JJ1SLR/MorseListening/README.md

# MorseListening
This is a project running on Arduino UNO/Nano.<br>
The first version (V0.1.0) of this project was released on Oct. 24, 2020<br>
It's a Morse code listening practice device to play Morse code by a passive buzzer and controlled by a infrared remote controller.<br>
[Detailed introduction (PDF, in Japanese) (PDF, 日本語)](https://github.com/JJ1SLR/MorseListening/blob/master/Document/MorseListening_JJ1SLR_JP.pdf)<br>

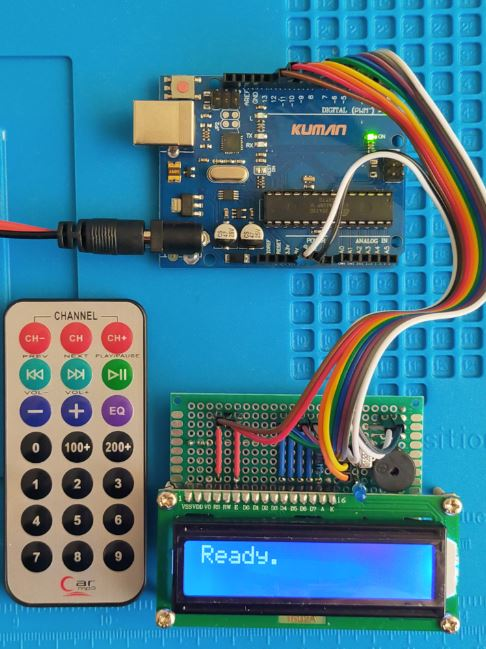
[picture p1: Document/images/overview.jpg]
Overview
<br>

The hardware is mainly constructed with the following parts:<br>
An Arduino UNO<br>
An LCD display 1602A <br>
An IR Receiver 1838<br>
A passive buzzer<br>
An LED<br>
A diode 1N4148<br>
Some resistors, etc.<br>

Circuit diagram<br>
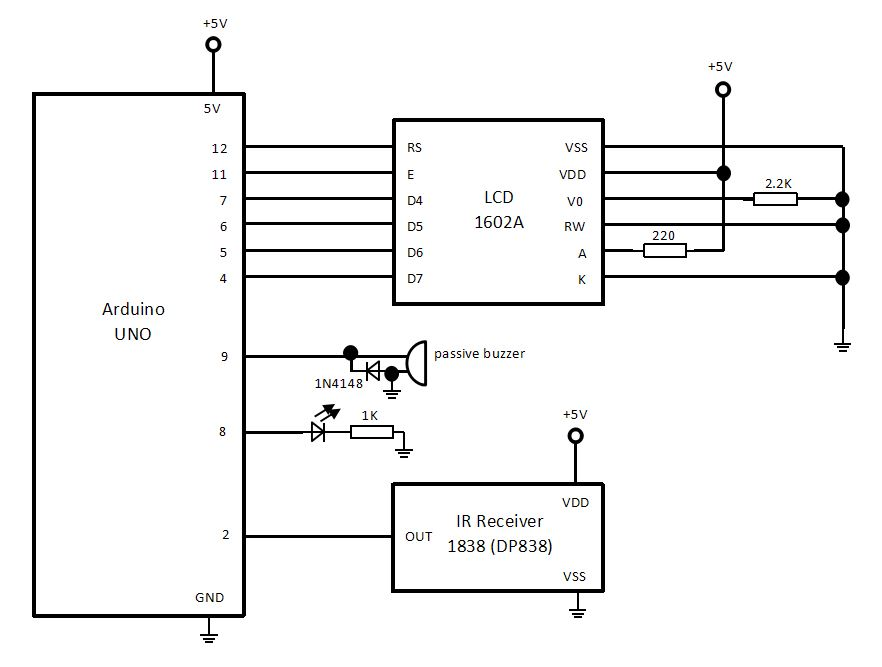
[picture p2: Document/circuit.JPG]
circuit diagram
<br>

The morse code here is stipulated by the Japanese law [無線局運用規則　別表第一号　モールス符号（第十二条関係）]
(https://www.tele.soumu.go.jp/horei/reiki_honbun/72393000001.html)<br>
But the Wabun code is not supported.
