JJ1SLR/MorseListening/Document/images/callsign.jpg

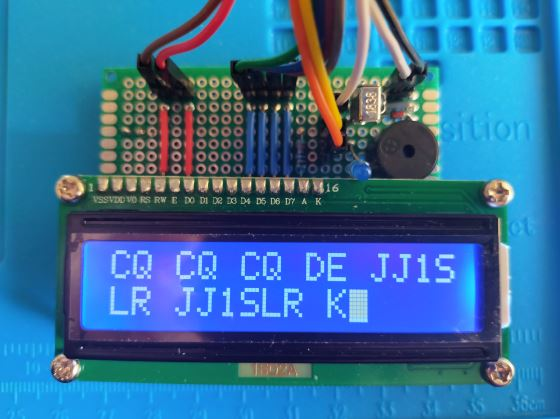
Document/images/callsign.jpg
