JJ1SLR/MorseListening/Document/images/case.jpg

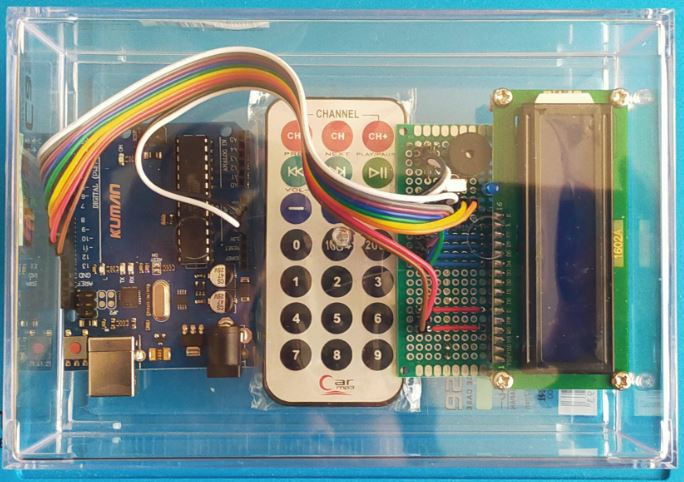
Document/images/case.jpg
