JJ1SLR/MorseListening/Document/images/charactor.jpg

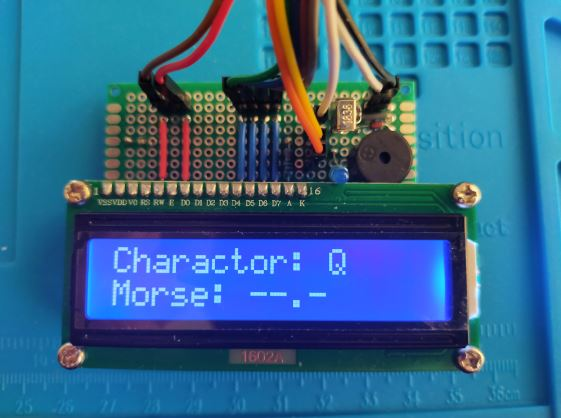
Document/images/charactor.jpg
