JJ1SLR/MorseListening/Document/images/random1.jpg

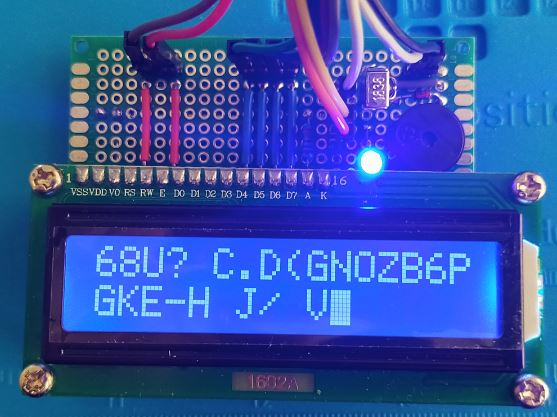
Document/images/random1.jpg
