JJ1SLR/MorseListening/Document/images/random2.jpg

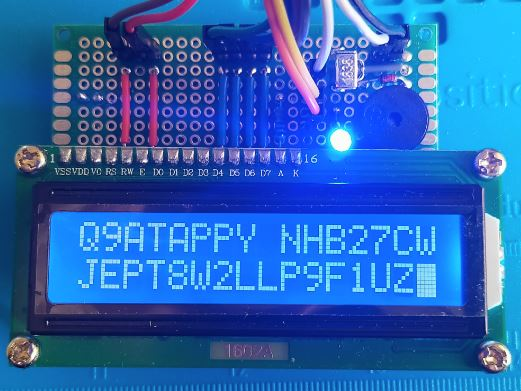
Document/images/random2.jpg
