JJ1SLR/MorseListening/Document/images/random3.jpg

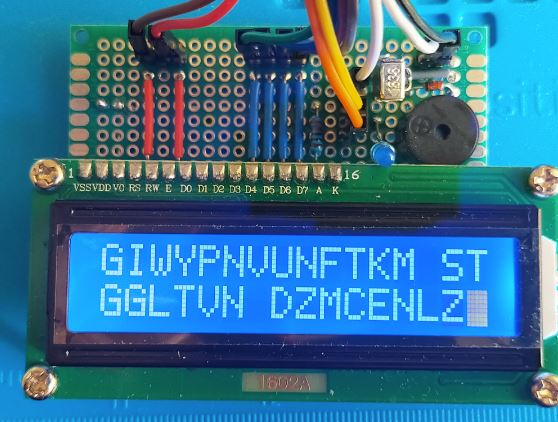
Document/images/random3.jpg
