JJ1SLR/MorseListening/(commit log)

2020-08-29 1. Output Morse code by the string variable. 2. It cannot run correctly by using PROGMEM declearation, so removed it.
    [MorseListening.ino]
2020-08-30 Add single char print function.
2020-08-30 1. Use delayWithCheck() instead of delay(). 2. Play in the same sequence of the Japanese law (無線局運用規則:別表第一号 モールス符号（第十二条関係）)
2020-10-24 Increase chances of play space char in mode 3 and 4.
    [MorseListening.ino]
2020-10-24 circuit diagram
    [circuit.xlsx]
2020-10-24 Update Readme.md, add circuit diagram.
2020-10-25 Add software_component_JP.xlsx document.
    [software_component_JP.xlsx]
2020-10-25 Update uncompleted MorseListening_JJ1SLR_JP.docx and software_component_JP.xlsx
    [software_component_JP.xlsx]
