JJ1SLR/MorseListening/(notices)

Notices in the files:
MorseListening.ino:
This program is free software: you can redistribute it and/or modify
it under the terms of the GNU General Public License as published by
the Free Software Foundation, version 3.
